meng-jixiang/vending-lane-controller/README.md

# 货道控制板 30×30 — 固件项目

> STM32F103C8T6 货道控制板固件，兼容 M109E 售货机控制卡协议

## 项目概述

30×30 货道控制板，驱动 900 通道出货机构，通过 RS-485 通讯与上位机对接。

| 项目 | 规格 |
|---|---|
| MCU | STM32F103C8T6 (72MHz, 64KB Flash, 20KB RAM) |
| 矩阵 | 30行×30列，74HC595×8片级联驱动 |
| 通讯 | RS-485, 9600bps, 兼容 M109E 协议 |
| 电流检测 | OPA2365 + 20mΩ 采样电阻, 增益21倍 |
| 输入 | 12路光耦（10路到位检测 + 2路光幕） |
| 输出 | 4路 NMOS 开关量 |
| 供电 | DC 24V → LM2596(5V) → AMS1117(3.3V) |

## 目录结构

```
├── docs/                       # 项目文档
│   ├── 固件开发项目规格书.md     # 需求规格 + 接口定义 + 验收标准
│   ├── 通讯协议规格书.md         # M109E 兼容协议详细定义
│   └── 硬件原理图分析.md         # 硬件资源分析
├── firmware/                    # 固件源码
│   ├── Core/                    # 系统初始化、启动文件
│   ├── Drivers/                 # 硬件驱动（595、ADC、UART、GPIO）
│   ├── App/                     # 应用层（电机控制、通讯协议）
│   └── Config/                  # 参数配置
├── hardware/                    # 硬件文件
│   ├── schematic/               # 原理图 PDF + 器件规格书
│   └── gerber/                  # PCB 生产文件
├── tools/                       # 上位机 / 调试工具
│   └── serial_test.py           # 串口协议测试脚本（待开发）
└── tests/                       # 测试用例
```

## 快速开始

### 硬件需求
- 货道控制板 30×30 V1.0
- ST-Link V2 或 J-Link 调试器
- DC 24V 电源
- RS-485 转 USB 适配器

### 开发环境
- Keil MDK 5.x 或 STM32CubeIDE
- ARM Compiler 6 或 GCC ARM
- STM32F1xx HAL Driver

### 编译烧录
```bash
# TODO: 补充具体编译命令
```

## 通讯协议

兼容 M109E 售货机控制卡，20 字节定长帧，CRC16-MODBUS 校验。

| 指令 | 功能 | 说明 |
|---|---|---|
| 0x01 | 获取序列号 | 返回 12 字节板卡 ID |
| 0x03 | 查询电机状态 | 运行状态/结果/电流/时间 |
| 0x05 | 启动电机 | 通道号+类型+光幕模式+超时 |
| 0x07 | 读温度 | NTC 温度值 |
| 0x08 | 开关量输出 | 4 路 NMOS 控制 |
| 0x09 | 读开关量输入 | 4 路 DI 状态 |
| 0x0B | 开停光幕 | 光幕开关 |
| 0x0C | 读光幕状态 | 遮挡检测 |
| 0x0D | 读光幕计时 | 遮挡毫秒数 |
| 0x10 | 读温湿度 | 温度 + 湿度 |
| 0x2A | 读单通道到位 | 到位开关状态 |
| 0x2B | 读一行到位 | 一行 30 通道状态 |
| 0xFF | 设置地址 | 广播设置从机地址(1-8) |

## 开发排期

| 阶段 | 周期 | 目标 |
|---|---|---|
| P0 环境搭建 | 第 1 天 | 工程模板 + 编译通过 + LED 闪烁 |
| P1 基础驱动 | 第 1 周 | 595 驱动 + UART + ADC |
| P2 通讯协议 | 第 2 周 | 帧收发 + CRC + 指令解析 |
| P3 电机控制 | 第 3-4 周 | 出货状态机 + 14 种类型 + 电流检测 |
| P4 辅助功能 | 第 5 周 | 光幕 + 继电器 + 温度 + 参数存储 |
| P5 测试验收 | 第 6 周 | 全测试用例通过 → 固件 V1.0 |

## 参考资料

- [M109E 售货机控制卡协议](docs/通讯协议规格书.md)
- [STM32F103 参考手册](https://www.st.com/resource/en/reference_manual/rm0008-stm32f101xx-stm32f102xx-stm32f103xx-stm32f105xx-and-stm32f107xx-arm-based-32-bit-mcus-stmicroelectronics.pdf)
- [74HC595 数据手册](https://www.ti.com/lit/ds/symlink/sn74hc595.pdf)

## License

Private — 仅供团队内部使用
