meng-jixiang/vending-lane-controller/docs/货道控制板30x30_固件开发项目规格书.md

# 货道控制板30×30 — 固件开发项目规格书

> **文档性质**：产品需求规格 + 技术方案 + 验收标准  
> **用途**：交付给固件开发人员，作为开发依据  
> **版本**：V1.0  
> **编制日期**：2026-06-29  

---

## 一、项目背景

### 1.1 目标
在已有30×30货道控制板硬件基础上，开发配套固件程序，实现900通道出货机构的驱动控制。

### 1.2 对标产品
- **参照产品**：M109E售货机控制卡（金华苏夏信息技术有限公司）
- **参照协议**：M109E通讯协议文档（已归档）

### 1.3 设计原则
- **协议向下兼容**：M109E上位机可直接控制本板（100通道子集）
- **裸机架构**：不使用RTOS，状态机驱动
- **资源精简**：适配STM32F103C8T6的64KB Flash / 20KB RAM

---

## 二、硬件平台确认

### 2.1 核心参数

| 项目 | 规格 | 备注 |
|---|---|---|
| MCU | STM32F103C8T6 | LQFP48, 72MHz |
| Flash | 64KB | 固件+参数存储 |
| RAM | 20KB | 状态表+缓冲区+栈 |
| 供电 | DC 24V | 经LM2596→5V→AMS1117→3.3V |
| 矩阵 | 30行×30列 | 74HC595×8片级联驱动（P端4+N端4） |
| 通道总数 | 900 | 单板全量 |

### 2.2 外设资源清单

| 外设 | 用途 | 引脚 | 备注 |
|---|---|---|---|
| USART1 | RS-485通讯 | PA9(TX)/PA10(RX) | 9600bps,主通讯口 |
| ADC1 CH0 | 电流检测通道1 | PA0 | OPA2365运放输出 |
| ADC1 CH1 | 电流检测通道2 | PA1 | 备用/电压检测 |
| GPIO | P端595控制 | PB10/PB11/PB14/PB15 | MR/STCP/SHCP/DS |
| GPIO | N端595控制 | PA4/PA5/PA6/PA7 | DS/SHCP/STCP/MR |
| GPIO | 光耦输入×12 | PB3-PB9,PB12-PB13,PA11-PA12 | 到位检测+光幕 |
| GPIO | 继电器输出×4 | PB0/PB1/PA2/PA3 | 通过光耦隔离 |
| GPIO | LED指示 | PA8 | 板载状态灯 |
| GPIO | 复位按键 | PC13 | 系统复位 |

### 2.3 光耦输入功能分配

| 输入 | GPIO | 功能 | 有效电平 | 说明 |
|---|---|---|---|---|
| INPUT_1 | PB13 | Row 0 到位检测 | 低=到位 | 30通道共享 |
| INPUT_2 | PB12 | Row 1 到位检测 | 低=到位 | 30通道共享 |
| INPUT_3 | PB9 | Row 2 到位检测 | 低=到位 | 30通道共享 |
| INPUT_4 | PB8 | Row 3 到位检测 | 低=到位 | 30通道共享 |
| INPUT_5 | PB7 | Row 4 到位检测 | 低=到位 | 30通道共享 |
| INPUT_6 | PB6 | Row 5 到位检测 | 低=到位 | 30通道共享 |
| INPUT_7 | PB5 | Row 6 到位检测 | 低=到位 | 30通道共享 |
| INPUT_8 | PB4 | Row 7 到位检测 | 低=到位 | 30通道共享 |
| INPUT_9 | PB3 | Row 8 到位检测 | 低=到位 | 30通道共享 |
| INPUT_10 | PA15 | Row 9 到位检测 | 低=到位 | 30通道共享 |
| INPUT_11 | PA12 | **光幕信号1** | 低=掉货 | NPN传感器 |
| INPUT_12 | PA11 | **光幕信号2** | 低=掉货 | 备用光幕 |

> **映射规则**：每行30个货道共享1个到位信号。启动Row N的任意货道时，检测INPUT_N判断到位。
> **Row 10-29**（600通道）无到位检测输入，仅靠超时+电流判断出货结果。

### 2.4 继电器输出分配

| 输出 | GPIO | 信号名 | 说明 |
|---|---|---|---|
| NMOS1 | PB0 | io_nmos1 | 开关量输出1 |
| NMOS2 | PB1 | io_nmos2 | 开关量输出2 |
| NMOS3 | PA2 | io_nmos3 | 开关量输出3 |
| NMOS4 | PA3 | io_nmos4 | 开关量输出4 |

### 2.5 595级联顺序

```
P端（行/正极）级联链：
  MCU → U4(Q24-Q31) → U3(Q16-Q23) → U2(Q8-Q15) → U1(Q0-Q7)
  发送顺序：先发U4数据，最后发U1数据（MSB先发）

N端（列/负极）级联链：
  MCU → U27(Q24-Q31) → U26(Q16-Q23) → U??(Q8-Q15) → U5(Q0-Q7)
  发送顺序：先发U27数据，最后发U5数据

对称结构：P端4片=32位（用30位），N端4片=32位（用30位）
```

---

## 三、功能需求

### 3.1 功能总览

| 编号 | 功能模块 | 优先级 | 说明 |
|---|---|---|---|
| F01 | 系统初始化 | P0 | 时钟/外设/看门狗初始化 |
| F02 | 74HC595矩阵驱动 | P0 | 行列选通，电机驱动基础 |
| F03 | 电机控制 | P0 | 启动/停止/状态机，兼容M109E的14种类型 |
| F04 | RS-485通讯协议 | P0 | 帧收发、CRC校验、指令解析 |
| F05 | 电流检测 | P0 | ADC采样、过流/欠流判断 |
| F06 | 到位检测 | P0 | 光耦输入读取、到位判断 |
| F07 | 光幕控制 | P1 | 光幕自检、掉货检测（IN11/IN12） |
| F08 | 开关量输出 | P1 | 4路继电器/NMOS控制 |
| F09 | 温度采集 | P1 | NTC温度读取与转换 |
| F10 | 参数存储 | P1 | 从机地址、配置参数掉电保存 |
| F11 | LED指示 | P2 | 板载LED状态指示 |
| F12 | 故障保护 | P1 | 过流/短路/超时保护 |

### 3.2 F02 — 74HC595矩阵驱动（详细）

#### 3.2.1 功能描述
通过7片74HC595级联，实现30行×30列矩阵的独立选通，控制900个通道的电机驱动。

#### 3.2.2 接口定义

```c
/**
 * @brief 初始化595控制引脚，全部输出低电平
 */
void HC595_Init(void);

/**
 * @brief 选通指定行（P端595）
 * @param row 行号 0-29，0xFF=全关
 * @note  同一时刻只能选通一行（或全关）
 *        选通=输出高电平，通过SS8050+4953驱动正极
 */
void HC595_SelectRow(uint8_t row);

/**
 * @brief 选通指定列（N端595）
 * @param col_mask 30位列的位掩码，bit0=列0...bit29=列29
 *                  1=选通（输出低，AO4812导通），0=断开
 * @note  可同时选通多列（一个电机或多电机同时驱动）
 */
void HC595_SetColumns(uint32_t col_mask);

/**
 * @brief 关闭全部输出（安全状态）
 */
void HC595_AllOff(void);
```

#### 3.2.3 时序要求
- SHCP（移位时钟）频率：1MHz ~ 4MHz（推荐2MHz）
- STCP（锁存脉冲）宽度：≥50ns
- MR（复位）脉冲宽度：≥100ns
- 移位完成后必须锁存（STCP上升沿）

#### 3.2.4 验收标准
- [ ] 能独立点亮30×30矩阵中任意一个交叉点的LED
- [ ] 能同时选通多列
- [ ] 全关操作后所有输出为低
- [ ] 移位无错位（连续切换不同行列，输出正确）

---

### 3.3 F03 — 电机控制（详细）

#### 3.3.1 电机类型定义（兼容M109E）

| 类型码 | 名称 | 驱动方式 | 到位检测 |
|---|---|---|---|
| 0x00 | 无反馈电磁铁 | P高+N低，固定时间 | 无 |
| 0x01 | 两线有反馈电磁铁 | P高+N低 | H信号 |
| 0x02 | 两线制电机 | P高+N低 | H信号（到位停） |
| 0x03 | 三线制电机 | P高+N低 | H信号（到位+运行中） |
| 0x04 | 12秒电插锁 | P高+N低，12秒超时 | 无 |
| 0x05 | 共正型两线电机 | 同0x02 | H信号 |
| 0x06 | 皮带货道 H→L→H | P高+N低 | H信号变化 |
| 0x07 | 皮带货道 L→H→L | P高+N低 | H信号变化 |
| 0x08 | 时间控制型电磁锁 | P高+N低，可配时间 | 无 |
| 0x09 | 三线有反馈电磁锁 | P高+N低 | H信号 |
| 0x0A | 反向两线（L10→L1） | 同0x02，引脚反序 | H信号 |
| 0x0B | 反向三线（L10→L1） | 同0x03，引脚反序 | H信号 |
| 0x0C | 反向无反馈电磁铁 | 同0x00，引脚反序 | 无 |
| 0x0D | 共正型无反馈电磁锁 | 同0x00 | 无 |
| 0x0E | 皮带货道 V2 | P高+N低 | H信号变化 |

> 注：类型0x0A-0x0C的"反向"在本板中不适用（595驱动无方向概念），可统一为0x02/0x03/0x00。

#### 3.3.2 出货流程状态机

```
                    ┌─────────┐
                    │  IDLE   │ ← 上位机查询结果后回到IDLE
                    └────┬────┘
                         │ 收到启动指令(0x05)
                         ▼
                    ┌─────────┐
                    │ PRECHECK│ 光幕自检（如需要）
                    └────┬────┘
                         │ 自检通过
                         ▼
                    ┌─────────┐
              ┌────→│ RUNNING │ 选通行列，启动电机
              │     └────┬────┘
              │          │ 到位/超时/光幕触发
              │          ▼
              │     ┌─────────┐
              │     │STOPPING │ 关闭驱动，记录结果
              │     └────┬────┘
              │          │
              │          ▼
              │     ┌─────────┐
              └─────┤  DONE   │ 等待上位机读取
                    └─────────┘
```

#### 3.3.3 接口定义

```c
/**
 * @brief 电机控制模块初始化
 */
void Motor_Init(void);

/**
 * @brief 启动指定通道的电机
 * @param row       行号 0-29
 * @param col       列号 0-29
 * @param type      电机类型 0x00-0x0E
 * @param laser_mode 光幕模式 0/1/2
 * @param detect_delay 微动检测延时 2-50 (×0.1s)
 * @param timeout   到位超时 1-250 (×0.1s)，0=默认7s
 * @param lock_time 时间锁动作时间 1-100 (×0.1s)
 * @return 0=已启动, 1=无效通道, 2=电机运行中, 3=上次结果未清除
 */
uint8_t Motor_Start(uint8_t row, uint8_t col, uint8_t type,
                    uint8_t laser_mode, uint8_t detect_delay,
                    uint8_t timeout, uint8_t lock_time);

/**
 * @brief 查询当前电机运行状态
 * @param status    输出：0=空闲, 1=执行中, 2=执行完毕
 * @param channel   输出：当前运行通道号 (row*30+col)
 * @param result    输出：执行结果（错误码）
 * @param peak_cur  输出：峰值电流(mA)
 * @param avg_cur   输出：平均电流(mA)
 * @param run_time  输出：运行时间(ms)
 * @param laser_cnt 输出：光幕遮挡时间(ms)
 */
void Motor_GetStatus(uint8_t *status, uint16_t *channel,
                     uint8_t *result, uint16_t *peak_cur,
                     uint16_t *avg_cur, uint16_t *run_time,
                     uint8_t *laser_cnt);

/**
 * @brief 主循环调用，驱动电机状态机
 * @note  每1ms调用一次
 */
void Motor_Process(void);
```

#### 3.3.4 执行结果码（兼容M109E）

| 代码 | 含义 | 判定条件 |
|---|---|---|
| 0x00 | 成功出货 | 到位信号有效 |
| 0x01 | 过流/负载过重/卡货 | 电流>阈值 |
| 0x02 | 欠流/断线/负载未接 | 电流<阈值 |
| 0x03 | 超时 | 超过timeout未到位 |
| 0x04 | 光幕自检失败 | 光幕模式1/2，自检时有遮挡 |
| 0x05 | 有反馈电磁铁门未开 | 类型0x01/0x09 |
| 0x0A | 微动开关未按下 | 三线制1.5s后H信号未变化 |

#### 3.3.5 验收标准
- [ ] 14种电机类型均能正确驱动
- [ ] 启动→到位→停止→返回结果 完整流程正确
- [ ] 过流/欠流/超时 故障码正确返回
- [ ] 光幕模式0/1/2 行为正确
- [ ] 连续出货100次无错位/误触发

---

### 3.4 F04 — RS-485通讯协议（详细）

#### 3.4.1 物理层
- 接口：USART1 → TP8485E-SR
- 波特率：9600bps
- 数据格式：8数据位，1停止位，无校验
- 总线模式：主从（主机=上位机，从机=货道板）
- 超时：主机等待响应超时1秒

#### 3.4.2 帧格式（兼容M109E）

```
指令帧（主机→从机），20字节：
┌──────┬──────┬──────────────────────┬──────────┐
│ 地址  │ 指令  │ Y1-Y16 数据（16字节）  │ CRC16    │
│ 1B   │ 1B   │ 16B                   │ 2B       │
└──────┴──────┴──────────────────────┴──────────┘

响应帧（从机→主机），20字节：
┌──────┬──────┬──────────────────────┬──────────┐
│ 地址  │ 指令  │ Z1-Z16 数据（16字节）  │ CRC16    │
│ 1B   │ 1B   │ 16B                   │ 2B       │
└──────┴──────┴──────────────────────┴──────────┘

CRC16-MODBUS: Poly=0x8005, Init=0xFFFF, 低字节在前
数据段不足16字节时补0
```

#### 3.4.3 通道编址方案

```
M109E兼容模式（Y1单字节）:
  Y1 = 通道号 (0-99)
  Y2 = 0

扩展模式（Y1+Y2双字节）:
  Y1 = 通道号低字节
  Y2 = 通道号高字节
  通道号 = Y1 + Y2×256 (范围 0-899)

  或者用行列方式（待定，建议与开发人员讨论选择）:
  Y1 = 行号 (0-29)
  Y2 = 列号 (0-29)
  通道号 = 行号 × 30 + 列号
```

> ⚠️ **待决策**：通道编址用"线性编号"还是"行列编号"？建议线性编号，与M109E更兼容。

#### 3.4.4 指令详细定义

##### 0x01 — 获取序列号

```
请求: [addr][01][00×16][CRC]
响应: [00][01][Z1-Z12=序列号][00×4][CRC]
```

##### 0x03 — 查询电机运行状态

```
请求: [addr][03][00×16][CRC]
响应: [00][03][Z1][Z2-Z3][Z4][Z5-Z6][Z7-Z8][Z9-Z10][Z11][00×5][CRC]

Z1:     运行状态 (0=空闲, 1=执行中, 2=完成)
Z2-Z3:  通道号 (16bit, 高字节在前)
Z4:     执行结果 (错误码)
Z5-Z6:  峰值电流 mA
Z7-Z8:  平均电流 mA
Z9-Z10: 运行时间 ms
Z11:    光幕遮挡时间 ms
```

##### 0x05 — 启动电机

```
请求: [addr][05][Y1][Y2][Y3][Y4][Y5][Y6][Y7][00×9][CRC]

Y1:     通道号低字节 (0-255)
Y2:     通道号高字节 (0=通道0-255, 1=256-511, 2=512-767, 3=768-899)
Y3:     电机类型 (0x00-0x0E)
Y4:     光幕模式 (0=不参考, 1=自检+到位停, 2=自检+掉货停)
Y5:     微动检测延时 2-50 (×0.1s)，默认15(1.5s)
Y6:     保留
Y7:     到位超时 1-250 (×0.1s)，0=默认70(7s)
Y8:     时间锁动作时间 1-100 (×0.1s)

响应: [00][05][Z1][00×15][CRC]
Z1: 启动结果 (0=已启动, 1=无效通道, 2=其他电机运行中, 3=上次结果未清除)
```

##### 0x07 — 读温度

```
请求: [addr][07][00×16][CRC]
响应: [00][07][Z1-Z2][00×14][CRC]

Z1-Z2: 温度值 (有符号16bit, ×0.1℃)
       例: 0x01F4 = 500 = 50.0℃
           0xFE0C = -500 = -50.0℃
       未接传感器返回 -50.0℃ (0xFE0C)
```

##### 0x08 — 开关量输出

```
请求: [addr][08][Y1][Y2][00×14][CRC]
Y1: DO索引 (0-3)
Y2: 操作 (1=ON, 0=OFF)

响应: [00][08][Z1][Z2][00×14][CRC]
Z1: DO索引
Z2: 操作结果 (Y2+0xF0)
```

##### 0x09 — 读开关量输入

```
请求: [addr][09][00×16][CRC]
响应: [00][09][Z1-Z4][00×12][CRC]

Z1-Z4: DI1-DI4状态 (1=外部连接, 0=断开)
```

##### 0x0B — 开停光幕

```
请求: [addr][0B][Y1][00×15][CRC]
Y1: 1=开, 0=关

响应: [00][0B][Z1][00×15][CRC]
Z1: 操作结果
```

##### 0x0C — 读光幕状态

```
请求: [addr][0C][00×16][CRC]
响应: [00][0C][Z1][Z2][00×14][CRC]

Z1: 光幕1状态 (1=有遮挡, 0=无遮挡) — INPUT_11
Z2: 光幕2状态 (1=有遮挡, 0=无遮挡) — INPUT_12
```

##### 0x0D — 读光幕遮挡计时

```
请求: [addr][0D][00×16][CRC]
响应: [00][0D][Z1][Z2][00×14][CRC]

Z1: 光幕1遮挡毫秒数
Z2: 光幕2遮挡毫秒数
注: 光幕开停时计数归零
```

##### 0x10 — 读温湿度

```
请求: [addr][10][00×16][CRC]
响应: [00][10][Z1][Z2][Z3][00×13][CRC]

Z1: 湿度 (本板无DHT11，固定返回0)
Z2: 温度 (同0x07指令)
Z3: 读取失败指示 (固定返回1，表示非最新采样)
```

##### 0x2A — 读单通道到位开关

```
请求: [addr][2A][Y1][Y2][00×14][CRC]
Y1: 通道号低字节
Y2: 通道号高字节

响应: [00][2A][Z1][00×15][CRC]
Z1: 0=未到位, 1=到位
```

##### 0x2B — 读一行到位开关

```
请求: [addr][2B][Y1][00×15][CRC]
Y1: 行号 (0-29)

响应: [00][2B][Z1-Z10][00×6][CRC]
Z1-Z10: 每列的到位状态 (bit0-bit7对应8个通道)
        共30列需要4字节，但M109E用10字节(100通道)
        本板需扩展或只返回前80通道
```

> ⚠️ **待讨论**：0x2B指令在30列时如何编码？建议用Z1-Z4(32bit)表示30列。

##### 0xFF — 设置从机地址

```
请求: [FF][01][00×16][CRC]  ← 设置为地址1
请求: [FF][02][00×16][CRC]  ← 设置为地址2
...
请求: [FF][08][00×16][CRC]  ← 设置为地址8

响应: 无（广播地址）
注意: 设置后指示灯闪烁次数=新地址
```

#### 3.4.5 通讯时序

```
主机发送指令
    ↓
等待 50ms
    ↓
从机响应（超时 1000ms）
    ↓
主机处理响应
    ↓
可发起下一条指令
```

#### 3.4.6 验收标准
- [ ] 所有指令均能正确收发
- [ ] CRC16校验正确（用M109E的示例数据验证）
- [ ] 20字节定长帧解析无误
- [ ] 地址匹配（只响应本机地址和广播地址255）
- [ ] 超时处理正确
- [ ] 连续收发1000帧无错误

---

### 3.5 F05 — 电流检测（详细）

#### 3.5.1 硬件参数
- 采样电阻：R85 = 20mΩ（GND与DGND之间）
- 运放：OPA2365AIDR（U23.1），同相放大器
- 输入电阻：R99 = 1kΩ
- 反馈电阻：R100 = 20kΩ
- **增益 = 1 + 20k/1k = 21倍**
- ADC串联保护：R108 = 10Ω
- 钳位二极管：D1 = 1N5819HW
- ADC：12bit，3.3V参考，通道ADCX_IN0 (PA0)

#### 3.5.2 换算公式

```
V_shunt = I_load × 0.020Ω
V_out   = V_shunt × 21 = I_load × 0.42 V/A
ADC值   = V_out / 3.3 × 4096

I_load(mA) = ADC值 × 1.91

参考值：
  1A  → ADC ≈ 524
  2A  → ADC ≈ 1048
  3A  → ADC ≈ 1572
  5A  → ADC ≈ 2620
```

#### 3.5.3 接口定义

```c
/**
 * @brief 电流检测模块初始化
 */
void ADC_Sense_Init(void);

/**
 * @brief 启动一次ADC采样（电机运行期间周期调用）
 * @note  建议每10ms采样一次
 */
void ADC_Sense_Start(void);

/**
 * @brief 获取当前电流值
 * @return 电流值(mA)
 */
uint16_t ADC_Sense_GetCurrent(void);

/**
 * @brief 获取本次运行的峰值电流
 * @return 峰值电流(mA)
 */
uint16_t ADC_Sense_GetPeak(void);
```

#### 3.5.4 电流判定阈值

| 场景 | 阈值 | ADC阈值 | 说明 |
|---|---|---|---|
| 过流 | >3250mA | ADC > 1701 | AO4812降额上限(70°C×50%) |
| 过流保护 | >4000mA | ADC > 2094 | 硬件极限保护 |
| 欠流 | <50mA | ADC < 26 | 返回错误码0x02 |
| 正常 | 50-3250mA | ADC 26-1701 | 正常范围 |

> **AO4812降额依据**：额定8.5A(25°C)/6.5A(70°C)，按50%降额 → 工作上限3.25A。
> 阈值需要实际电机测试后微调，以上为初始计算值。

#### 3.5.4 验收标准
- [ ] 静态电流读数稳定（无电机运行时接近0mA）
- [ ] 电机运行时电流读数与万用表偏差<10%
- [ ] 过流/欠流判定正确

---

### 3.6 F07 — 光幕控制（详细）

#### 3.6.1 硬件连接
- 光幕1：INPUT_11 (PA12) — NPN型光幕传感器
- 光幕2：INPUT_12 (PA11) — 备用光幕
- 光幕供电：需外部供电（本板不控制光幕电源）

#### 3.6.2 信号逻辑
- **常态（无掉货）**：NPN截止 → 4.7kΩ上拉至+24V → 光耦截止 → MCU读到**高电平**
- **掉货检测**：NPN导通 → 拉低 → 光耦导通 → MCU读到**低电平**
- **有效电平**：**低电平 = 检测到掉货**

```
无掉货:  PA12/PA11 = HIGH (1)
有掉货:  PA12/PA11 = LOW  (0)
```

#### 3.6.3 工作模式（兼容M109E）

| 模式 | 说明 |
|---|---|
| 0 | 电机运转不参考光幕 |
| 1 | 启动前光幕自检→自检通过才启动→到位后停止 |
| 2 | 启动前光幕自检→自检通过才启动→掉货检测到立即停止→未检测到则超时停止 |

#### 3.6.4 光幕自检逻辑

```
自检流程:
1. 读取INPUT_11/INPUT_12状态
2. 如果为低电平（有遮挡/有掉货）→ 自检失败 → 返回错误码0x04
3. 如果为高电平（无遮挡）→ 自检通过 → 启动电机

掉货检测（模式2）:
1. 电机运行中持续监测INPUT_11/INPUT_12
2. 检测到低电平（NPN导通=掉货）→ 记录遮挡时间 → 立即停止电机
3. 遮挡时间 > 0 表示有掉货
```

#### 3.6.5 验收标准
- [ ] 模式0：光幕状态不影响电机运行
- [ ] 模式1：光幕为低电平（掉货）时自检失败，返回0x04
- [ ] 模式2：电机运行中检测到低电平后立即停止
- [ ] 遮挡计时准确
- [ ] 常态（高电平）时不会误触发

---

### 3.7 F10 — 参数存储（详细）

#### 3.7.1 需存储的参数

| 参数 | 大小 | 说明 |
|---|---|---|
| 从机地址 | 1字节 | 1-8 |
| 电机类型配置表 | 300字节 | 每通道1字节（可选，或由上位机管理） |
| 电流校准值 | 4字节 | 零点偏移+增益系数 |
| 序列号 | 12字节 | 板卡唯一标识 |

#### 3.7.2 存储方案
使用STM32 Flash模拟EEPROM（页擦除方式）：
- 使用Flash最后1-2页（每页1KB）
- 需要均衡磨损算法

#### 3.7.3 验收标准
- [ ] 掉电后参数不丢失
- [ ] 修改参数后重新上电读取正确
- [ ] Flash写入次数>10000次无损坏

---

## 四、RAM分配方案

```
STM32F103C8T6 RAM = 20480 字节

分配：
  栈 (Stack)              : 2048 字节
  堆 (Heap)               : 512 字节
  .bss + .data (全局变量)  : ~1500 字节
  通讯收发缓冲            : 40+40 = 80 字节
  ADC采样缓冲             : 64 字节
                         ──────────────
  固定开销                : ~4200 字节

  货道状态表 (300通道)     : 1500 字节 (5字节/通道)
  电机运行上下文           : 32 字节
  故障日志 (最近10条)      : 100 字节
                         ──────────────
  业务数据                : ~1632 字节

  总计                    : ~5832 字节
  剩余                    : ~14648 字节 ✅ 充裕
```

---

## 五、Flash分配方案

```
STM32F103C8T6 Flash = 65536 字节

分配：
  Bootloader (可选)       : 4096 字节 (0x0000-0x0FFF)
  固件代码                : ~40000 字节 (预估)
  参数存储区              : 2048 字节 (最后2页)
  向量表 + 中断           : ~512 字节
                         ──────────────
  总计                    : ~46656 字节
  剩余                    : ~18880 字节 ✅ 可行
```

---

## 六、开发交付物清单

| 编号 | 交付物 | 格式 | 说明 |
|---|---|---|---|
| D01 | 源代码工程 | Keil MDK / STM32CubeIDE | 含Makefile/工程文件 |
| D02 | 协议文档 | .md 或 .pdf | 所有指令的详细定义 |
| D03 | 接口文档 | .md 或 .pdf | 所有模块的API说明 |
| D04 | 测试报告 | .md 或 .pdf | 各模块测试结果 |
| D05 | 已烧录固件 | .hex / .bin | 可直接烧录的固件文件 |
| D06 | 串口调试工具 | .exe / .py | 可选，用于测试指令收发 |

---

## 七、验收测试用例

### 7.1 基础功能测试

| 编号 | 测试项 | 操作 | 预期结果 |
|---|---|---|---|
| T01 | 上电初始化 | 上电 | LED闪烁N次(N=从机地址)，串口无异常输出 |
| T02 | 获取ID | 发送0x01指令 | 返回12字节序列号 |
| T03 | 设置地址 | 发送0xFF指令 | 指示灯闪烁次数变化，新地址生效 |
| T04 | 读温度 | 发送0x07指令 | 返回NTC温度值，未接时返回-50.0℃ |
| T05 | 开关量输出 | 发送0x08指令 | 对应NMOS导通/关断 |
| T06 | 读开关量 | 发送0x09指令 | 返回DI1-DI4状态 |

### 7.2 电机驱动测试

| 编号 | 测试项 | 操作 | 预期结果 |
|---|---|---|---|
| T10 | 无反馈电磁铁 | 类型0x00，启动通道(0,0) | 运行timeout后返回0x00(成功) |
| T11 | 两线制电机 | 类型0x02，启动通道(0,0) | 到位后返回0x00 |
| T12 | 三线制电机 | 类型0x03，启动通道(0,0) | 到位后返回0x00 |
| T13 | 过流故障 | 启动短路通道 | 返回0x01 |
| T14 | 超时故障 | 启动无负载通道 | 返回0x03 |
| T15 | 通道冲突 | 运行中再发启动 | 返回0x02(电机运行中) |
| T16 | 全通道遍历 | 依次启动(0,0)到(29,29) | 每个通道均能正确启动 |

### 7.3 光幕测试

| 编号 | 测试项 | 操作 | 预期结果 |
|---|---|---|---|
| T20 | 光幕自检通过 | 模式1，光幕无遮挡 | 正常启动电机 |
| T21 | 光幕自检失败 | 模式1，遮挡光幕 | 返回0x04 |
| T22 | 掉货检测 | 模式2，运行中遮挡光幕 | 电机立即停止 |
| T23 | 读光幕状态 | 发送0x0C | 返回双光幕状态 |

### 7.4 稳定性测试

| 编号 | 测试项 | 操作 | 预期结果 |
|---|---|---|---|
| T30 | 连续出货 | 循环出货1000次 | 无死机/错位/误触发 |
| T31 | 通讯压力 | 1秒发10条指令 | 全部正确响应，无丢帧 |
| T32 | 掉电恢复 | 运行中突然断电 | 重启后正常工作 |
| T33 | 长时间运行 | 连续运行72小时 | 无异常 |

---

## 八、风险与待确认事项

### 8.1 待确认（需与硬件确认）

| 编号 | 问题 | 影响 | 建议 |
|---|---|---|---|
| Q01 | ~~N端595只有3片=24位~~ | ~~矩阵驱动方案~~ | ✅ 已确认：N端4片=32位，足够30路 |
| Q02 | ~~电流检测运放增益是多少？~~ | ~~电流检测精度~~ | ✅ 已确认：增益21倍，I(mA)=ADC×1.91 |
| Q03 | ~~光幕信号的有效电平？~~ | ~~光幕逻辑~~ | ✅ 已确认：NPN传感器，低电平=掉货，常态高电平 |
| Q04 | ~~到位检测(INPUT_1~10)的映射关系？~~ | ~~到位检测方案~~ | ✅ 已确认：Row0→IN1, Row1→IN2, ...Row9→IN10，每行30通道共享 |
| Q05 | ~~电机驱动电流最大多少？AO4812额定电流是否够用？~~ | ~~可靠性~~ | ✅ 已确认：AO4812额定8.5A/6.5A(70°C)，50%降额→上限3.25A |

### 8.2 已知风险

| 风险 | 概率 | 影响 | 应对 |
|---|---|---|---|
| RAM不足 | 低 | 功能受限 | 已精简到5字节/通道，预留充裕 |
| Flash不足 | 低 | 无法存储全部功能 | 64KB够用，控制代码量 |
| 电流检测精度不足 | 中 | 误判故障 | 需实测校准，软件滤波 |
| 595移位错位 | 中 | 误触发货 | 每次操作前复位595 |
| 通讯抗干扰差 | 中 | 丢帧 | 重试机制+超时处理 |

---

## 九、开发环境要求

| 项目 | 要求 |
|---|---|
| IDE | Keil MDK 5.x 或 STM32CubeIDE |
| 编译器 | ARM Compiler 6 或 GCC ARM |
| HAL库 | STM32F1xx HAL Driver |
| 调试器 | ST-Link V2 或 J-Link |
| 测试工具 | 串口调试助手（SSCOM/友善串口） |
| 参考文档 | M109E协议文档、STM32F103参考手册 |

---

## 十、项目排期建议

| 阶段 | 周期 | 内容 | 交付物 |
|---|---|---|---|
| **阶段一：基础驱动** | 第1-2周 | 595驱动、GPIO、UART、ADC | LED扫描+串口收发 |
| **阶段二：核心功能** | 第3-4周 | 电机控制、通讯协议、电流检测 | 完整出货流程 |
| **阶段三：辅助功能** | 第5周 | 光幕、继电器、温度、参数存储 | 全功能可用 |
| **阶段四：测试验收** | 第6周 | 全部测试用例执行、Bug修复 | 固件V1.0 |

---

> **文档版本**：V1.0  
> **编制**：产品经理  
> **日期**：2026-06-29  
> **状态**：待团队评审
