meng-jixiang/vending-lane-controller/CHANGELOG.md

# Changelog

## [Unreleased] - 2026-07-02

### Added
- 项目初始化
- 固件开发项目规格书 V1.0
- 通讯协议规格书 V1.0（M109E 兼容）
- 硬件原理图分析文档
- PCB Gerber 文件（2026-06-29 版本）
- MOSFET 4953 规格书
