meng-jixiang/vending-lane-controller/hardware/schematic/SCH_Schematic1_2026-06-29.pdf

# MR# 10 SHCP 11 STCP 12 OE# 13 DS 14 Q0 15 VCC 16

# MR# 10 SHCP 11 STCP 12 OE# 13 DS 14 Q0 15 VCC 16

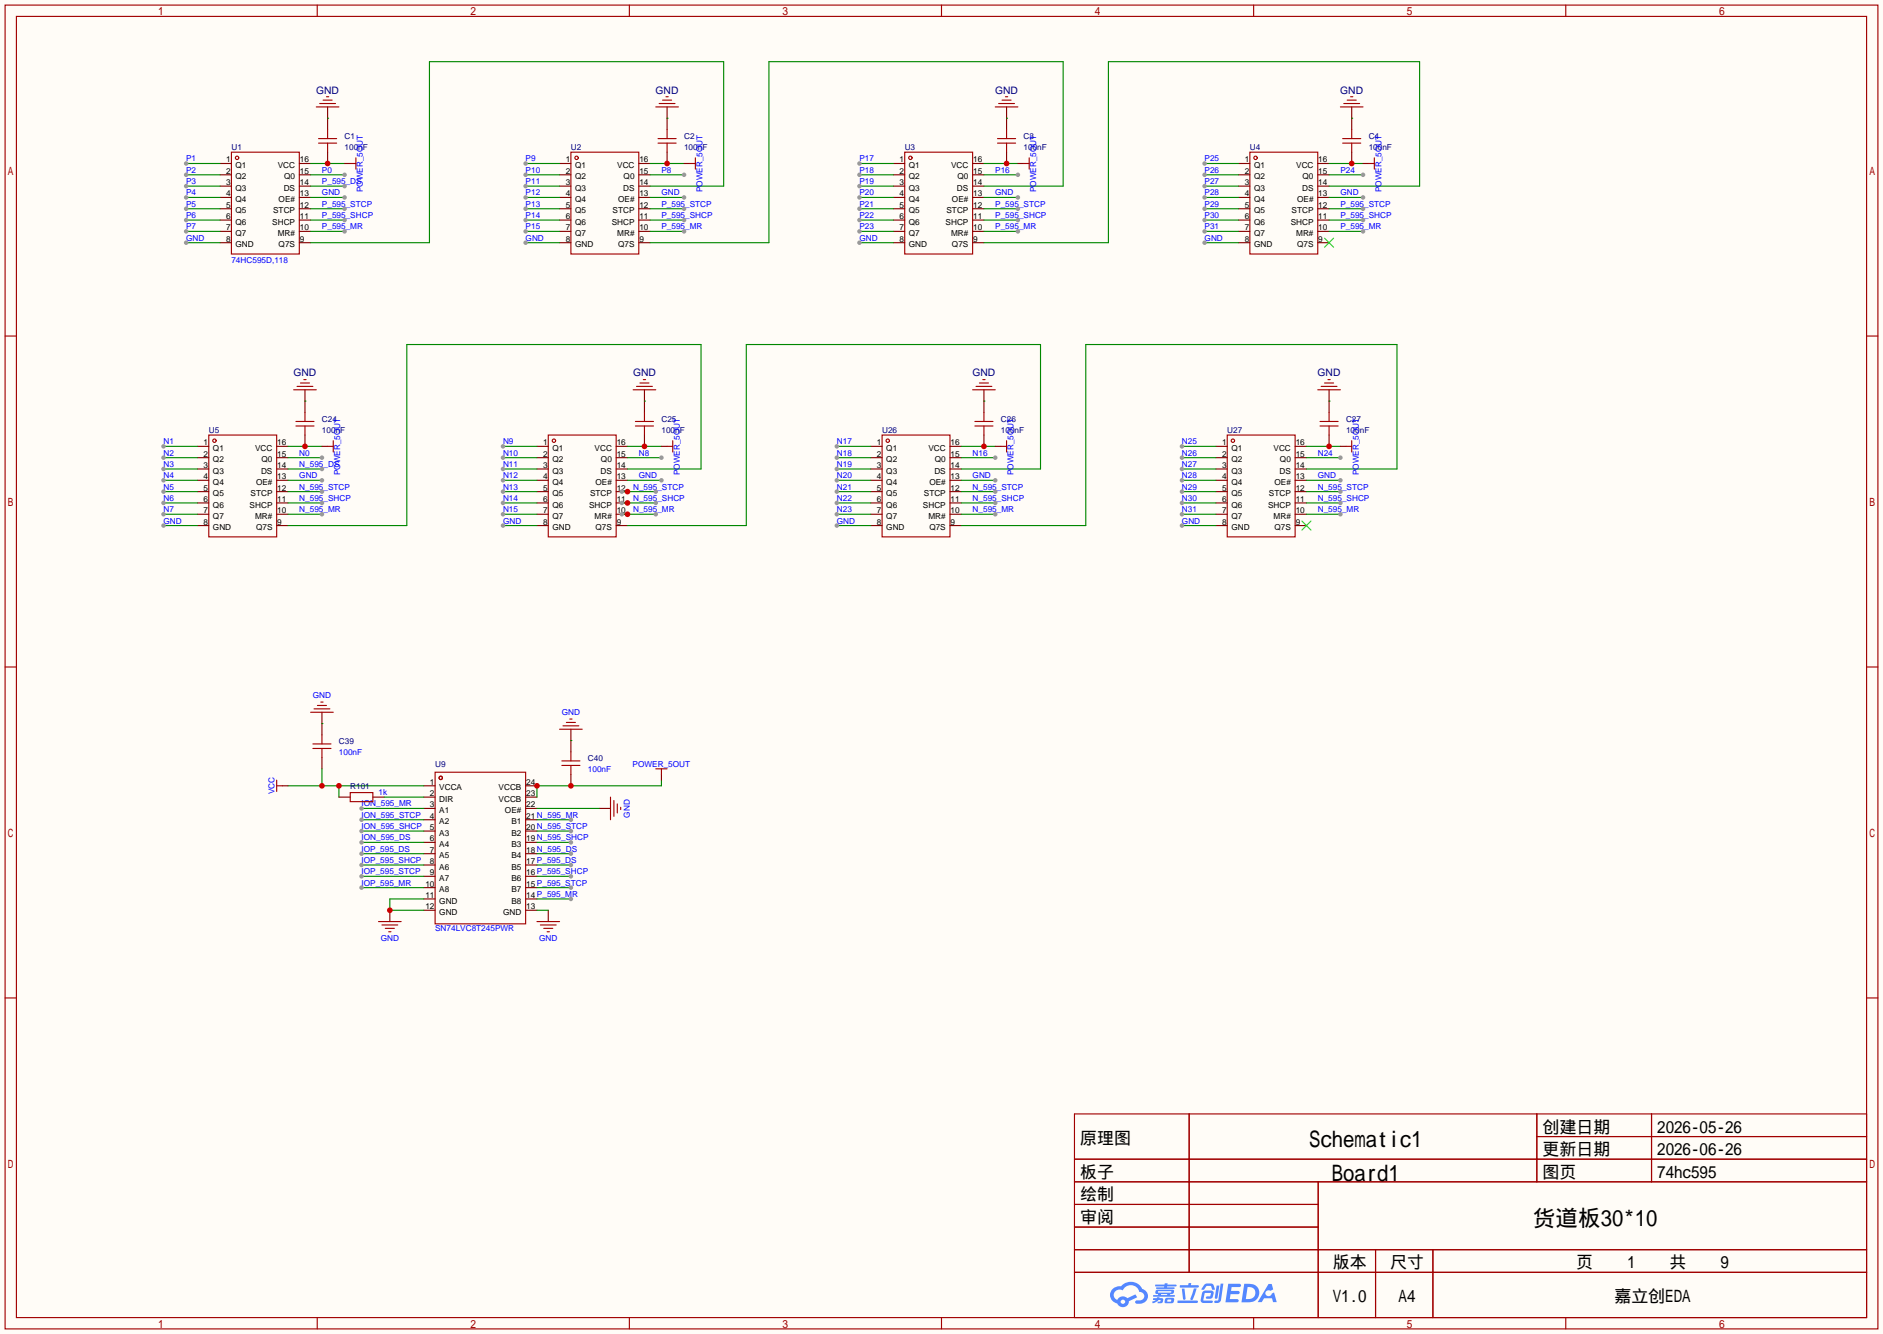
[picture p1: page 1]

MR# 10 SHCP 11 STCP 12 OE# 13 DS 14 Q0 15 VCC 16

原理图 | Schematic1 | 创建日期 | 2026-05-26

更新日期 | 2026-06-26

板子 | Board1 | 图页 | 74hc595
绘制 | | 货道板30*10
审阅

V1.0 | A4 | 嘉立创EDA

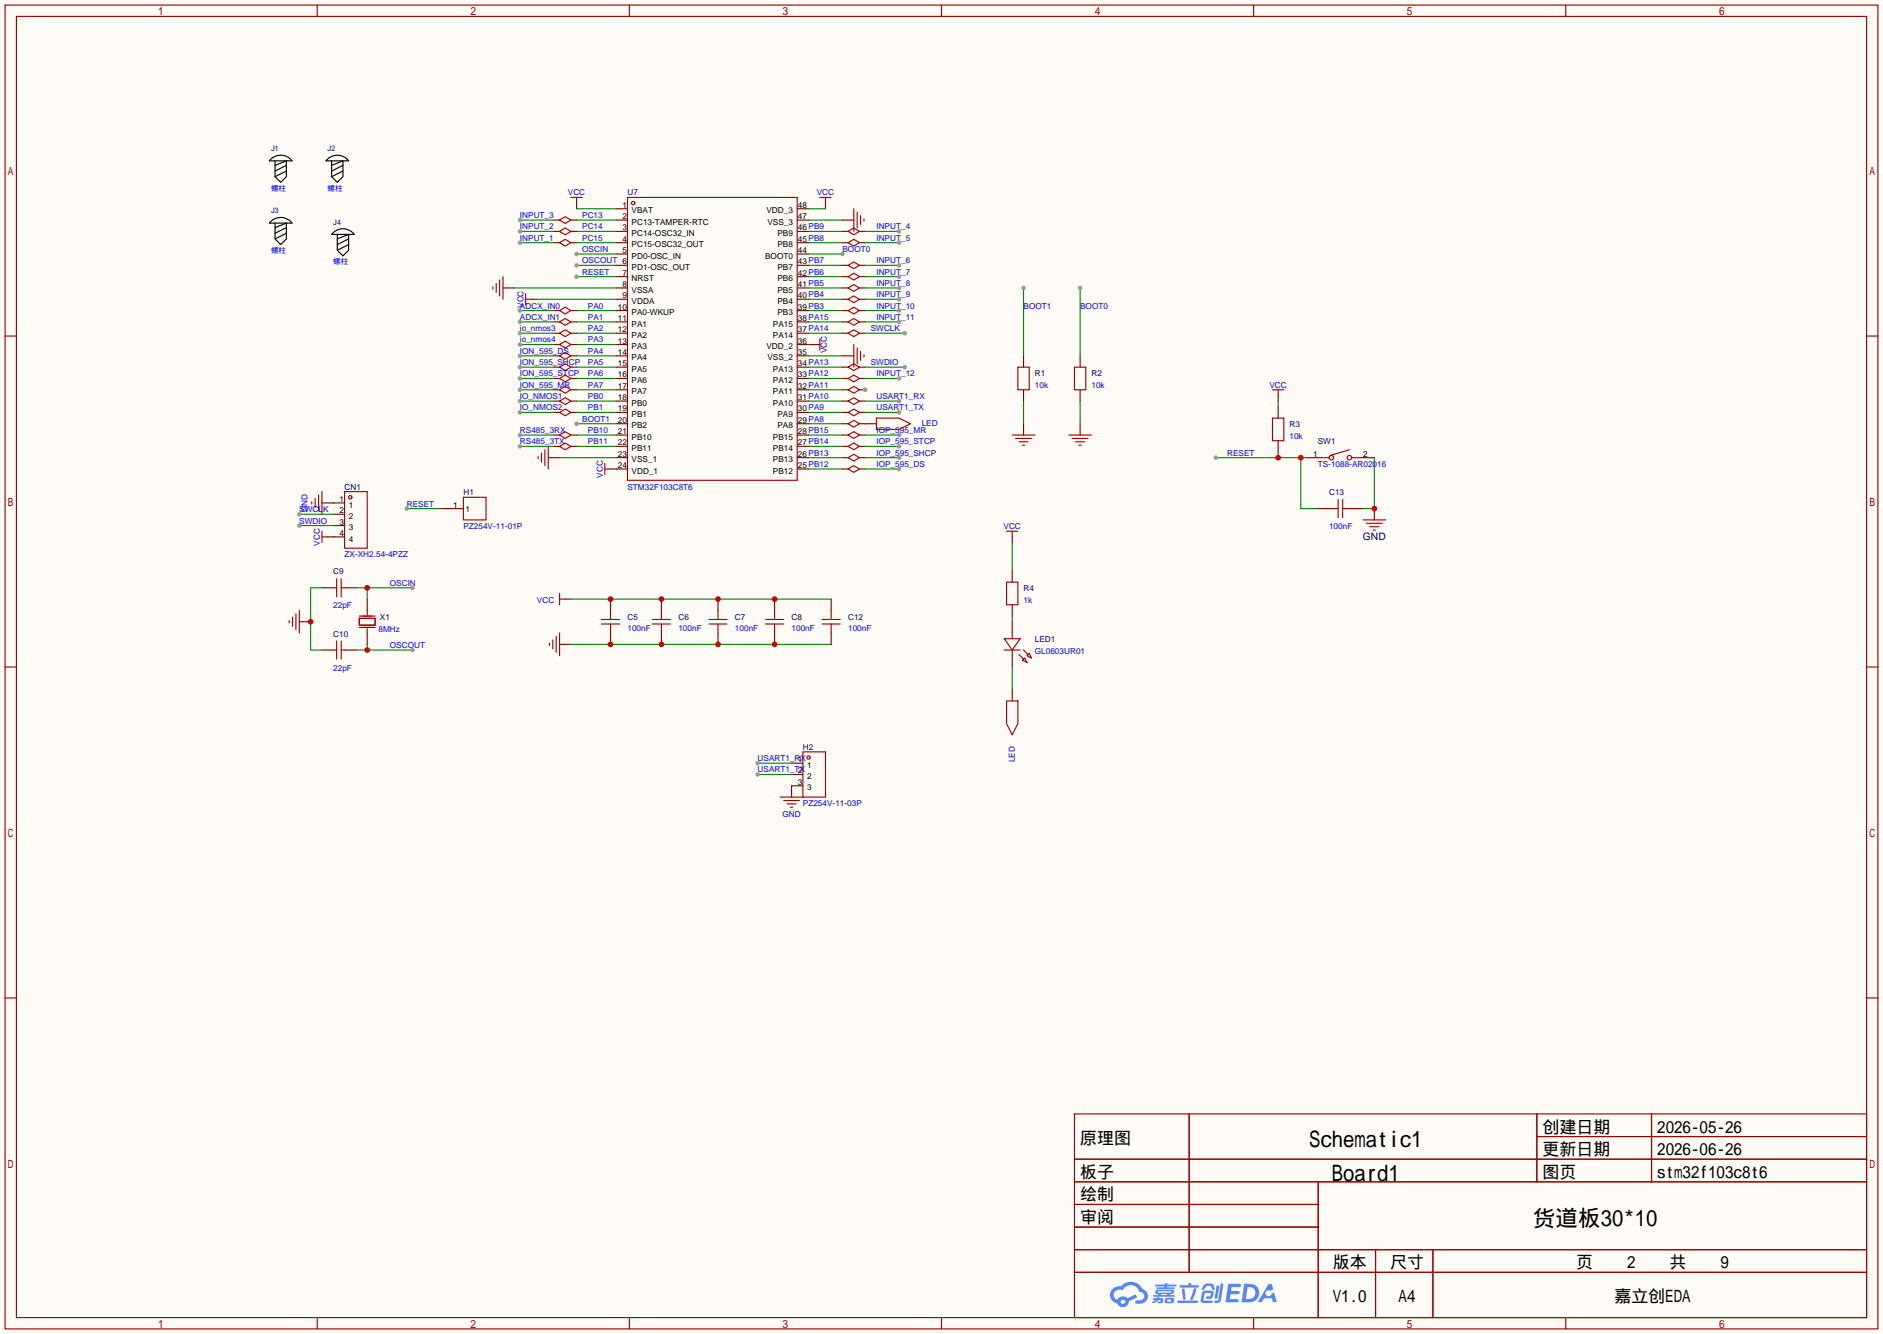
[picture p2: page 2]

原理图 | Schematic1 | 创建日期 | 2026-05-26

更新日期 | 2026-06-26

板子 | Board1 | 图页 | stm32f103c8t6
绘制 | | 货道板30*10
审阅

GND | GND | GND | GND | GND P⁰ | P¹ | P² | P³ | P⁴ P⁵ | P⁶ | P⁷ | P⁸ | P⁹ P¹⁰ | P¹¹ | P¹² | P¹³ | P¹⁴ P¹⁵ | P¹⁶ | P¹⁷ | P¹⁸ | P¹⁹ P²⁰ | P²¹ | P²² | P²³ | P²⁴ P²⁵ | P²⁶ | P²⁷ | P²⁸ | P²⁹

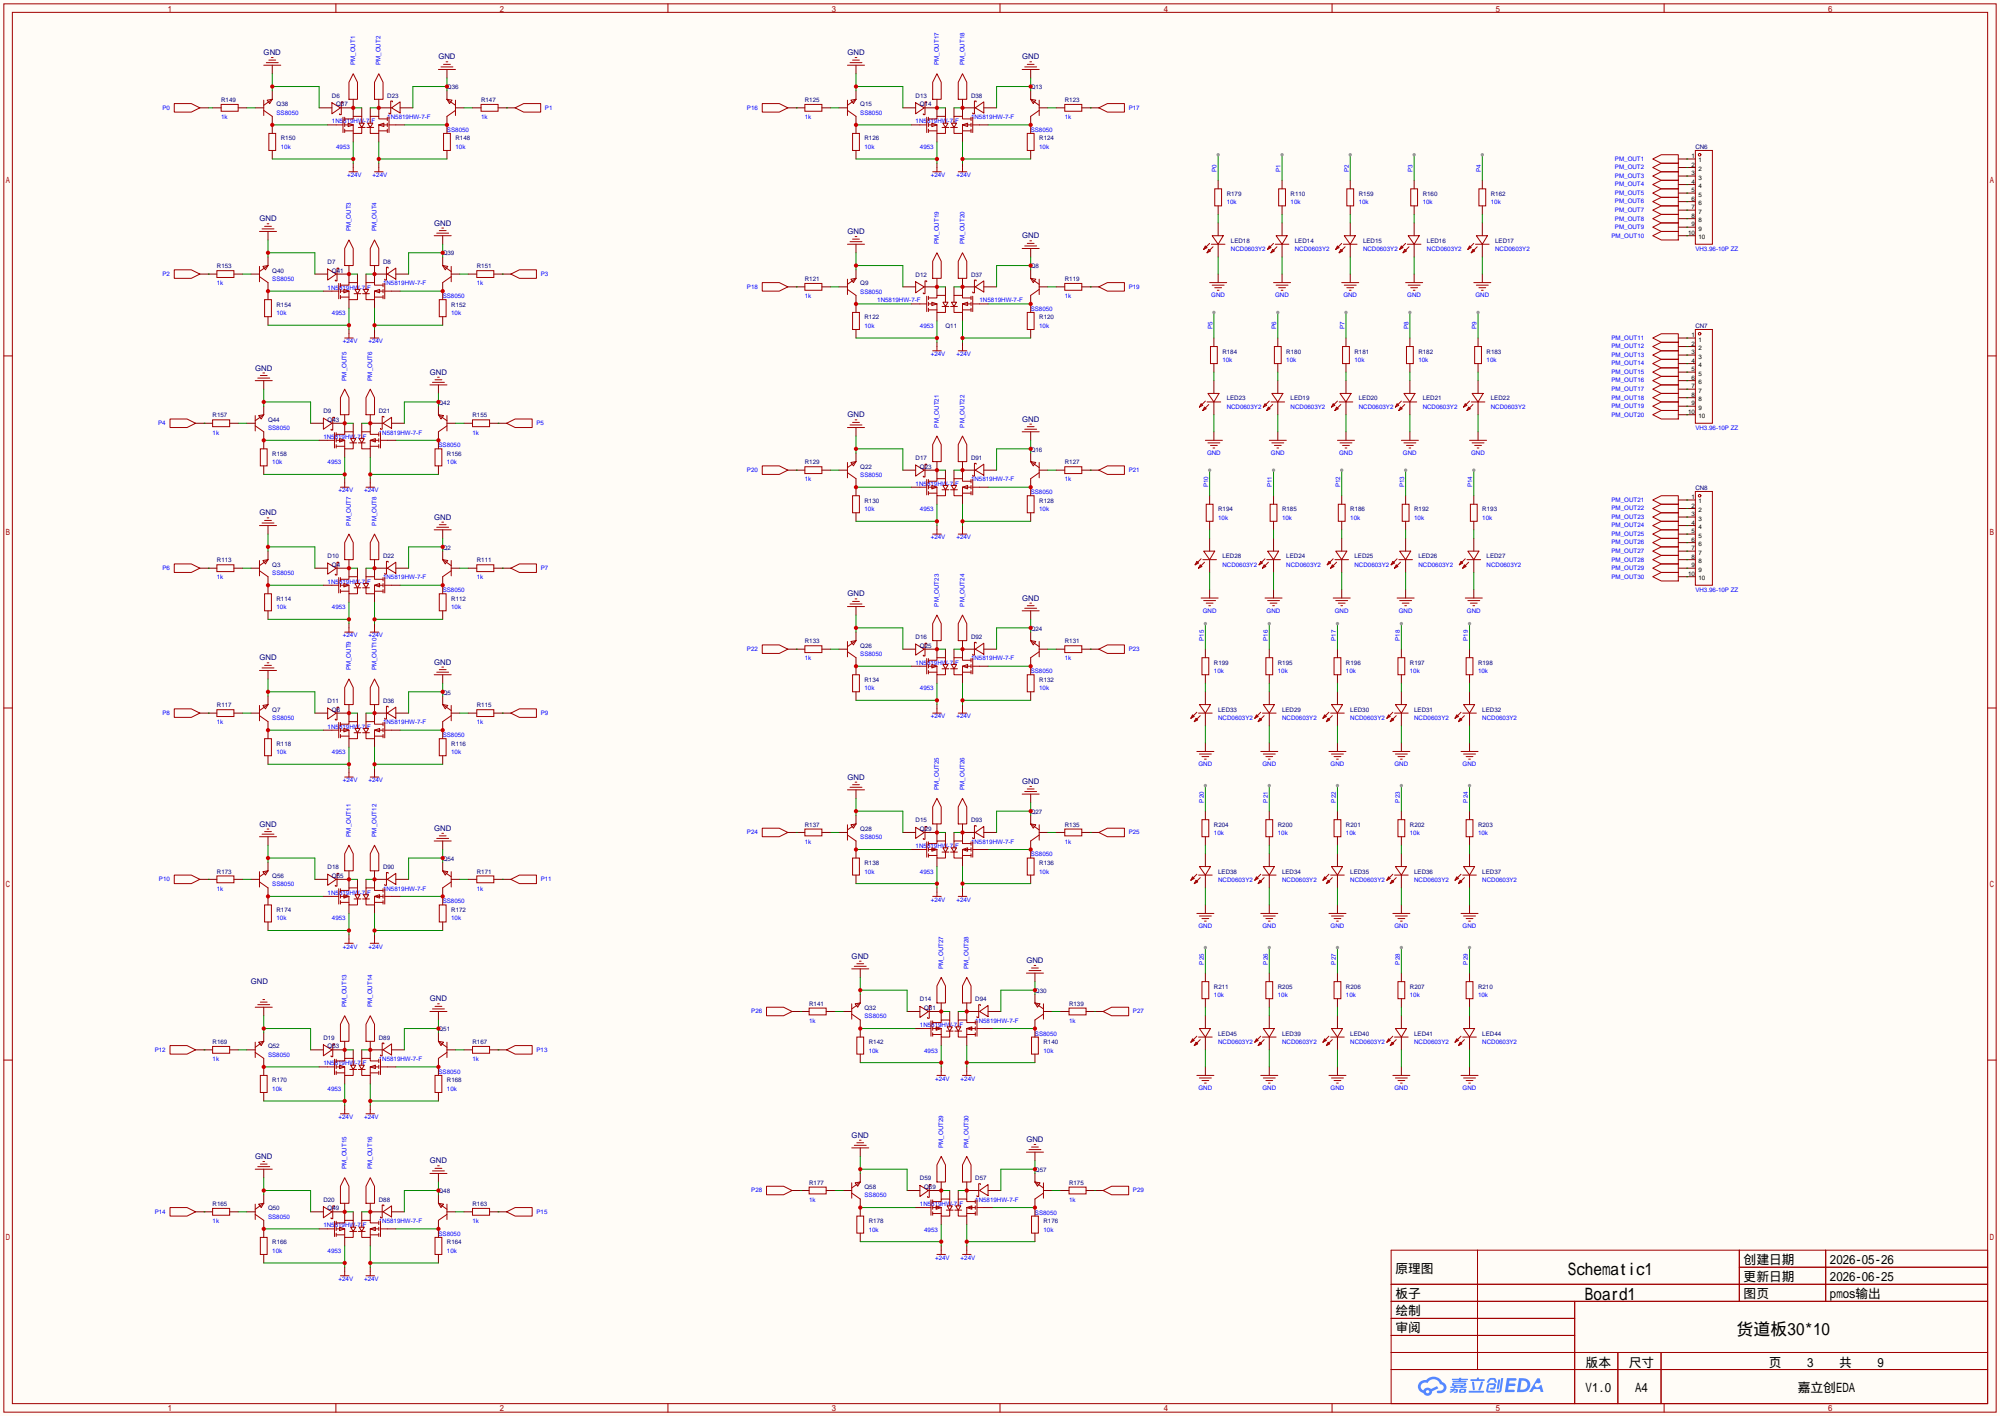
[picture p3: page 3]

原理图 | Schematic1 | 创建日期 | 2026-05-26

更新日期 | 2026-06-25

板子 | Board1 | 图页 | pmos输出
绘制 | | 货道板30*10
审阅

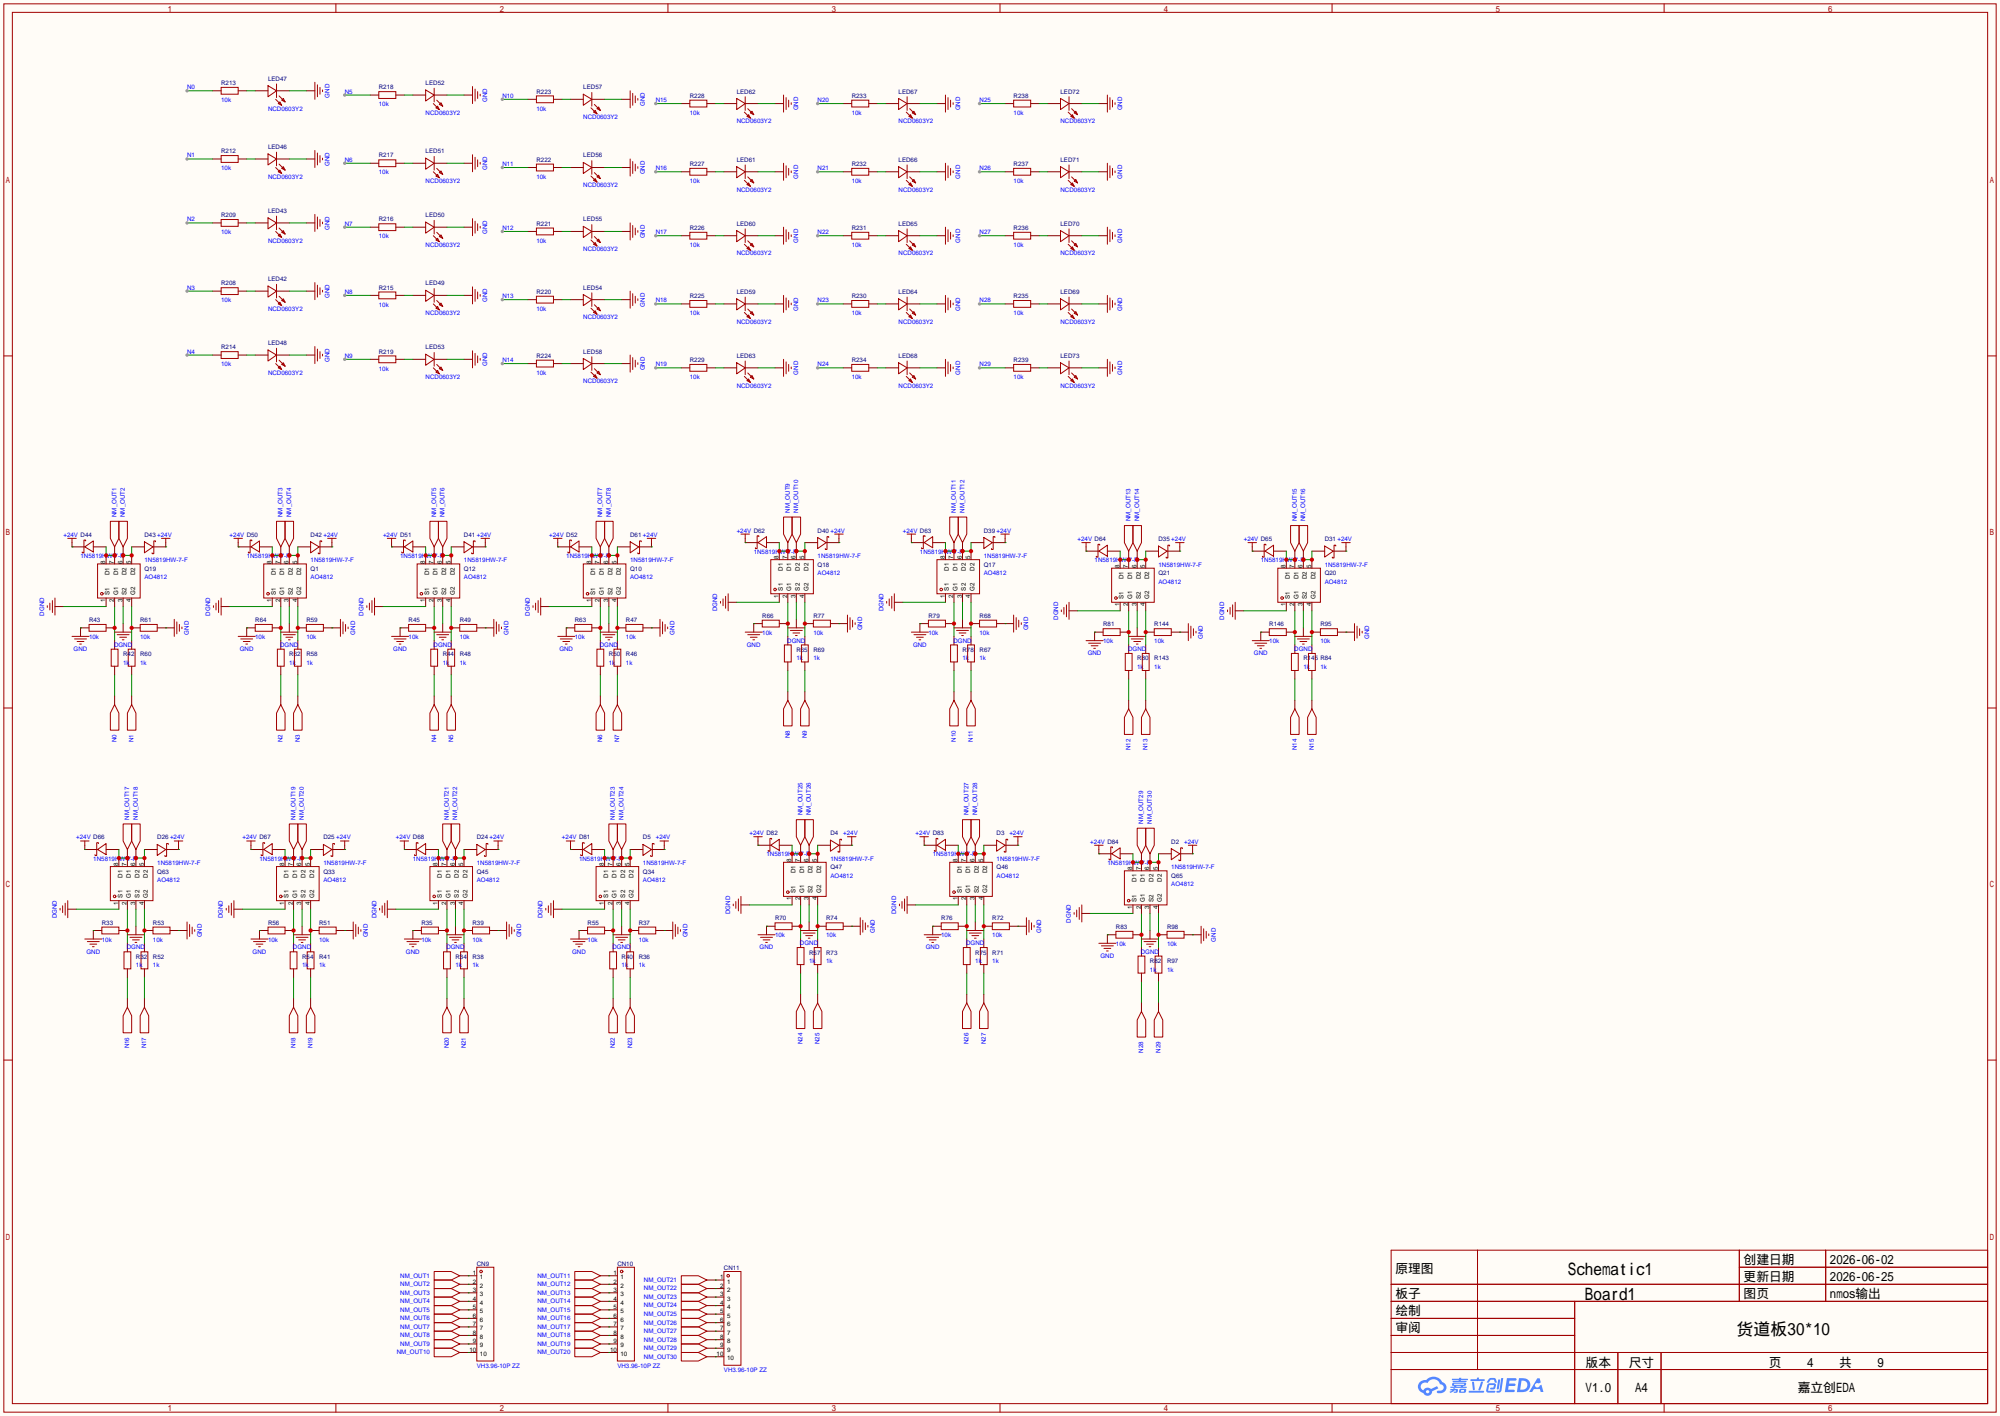
[picture p4: page 4]

GND GND GND GND GND

原理图 | Schematic1 | 创建日期 | 2026-06-02

更新日期 | 2026-06-25

板子 | Board1 | 图页 | nmos输出
绘制 | | 货道板30*10
审阅

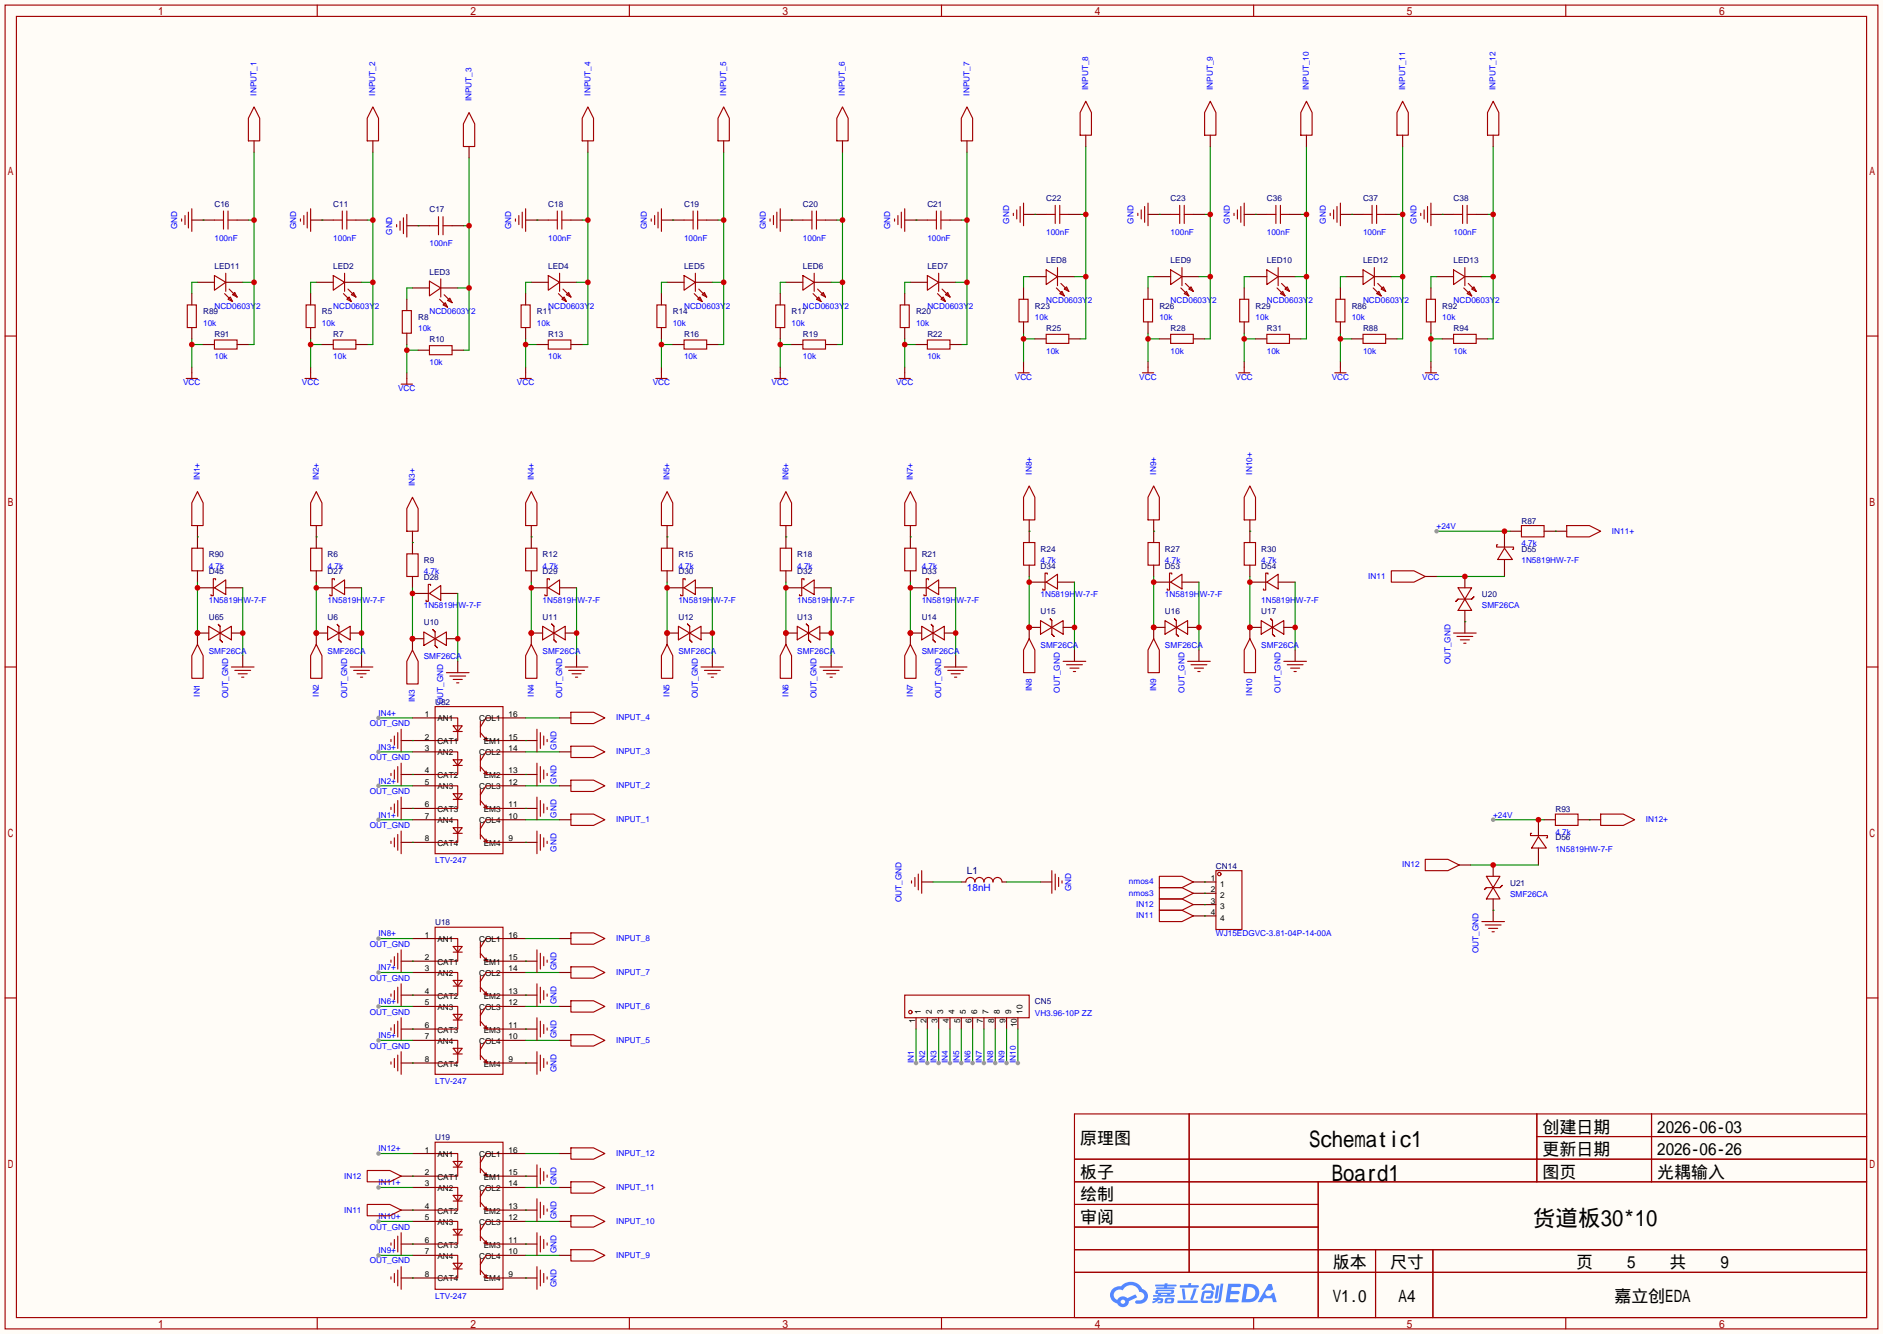
[picture p5: page 5]

GND GND GND GND GND GND

原理图 | Schematic1 | 创建日期 | 2026-06-03

更新日期 | 2026-06-26

板子 | Board1 | 图页 | 光耦输入
绘制 | | 货道板30*10
审阅

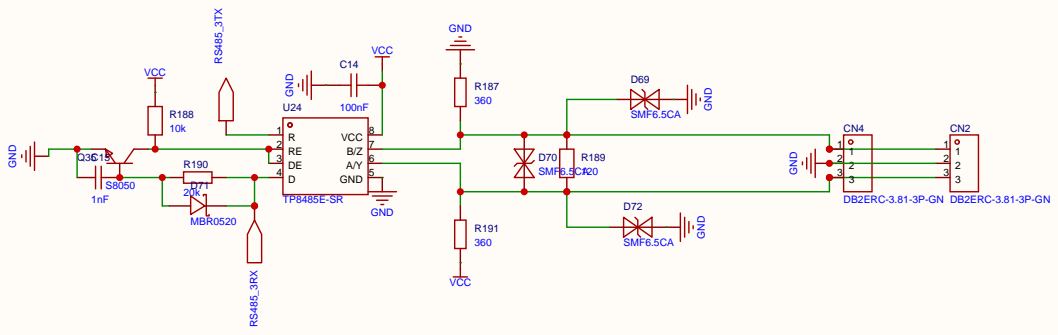
[picture p6: page 6]

原理图 | Schematic1 | 创建日期 | 2026-06-04

更新日期 | 2026-06-12

板子 | Board1 | 图页 | 485通讯
绘制 | | 货道板30*10
审阅

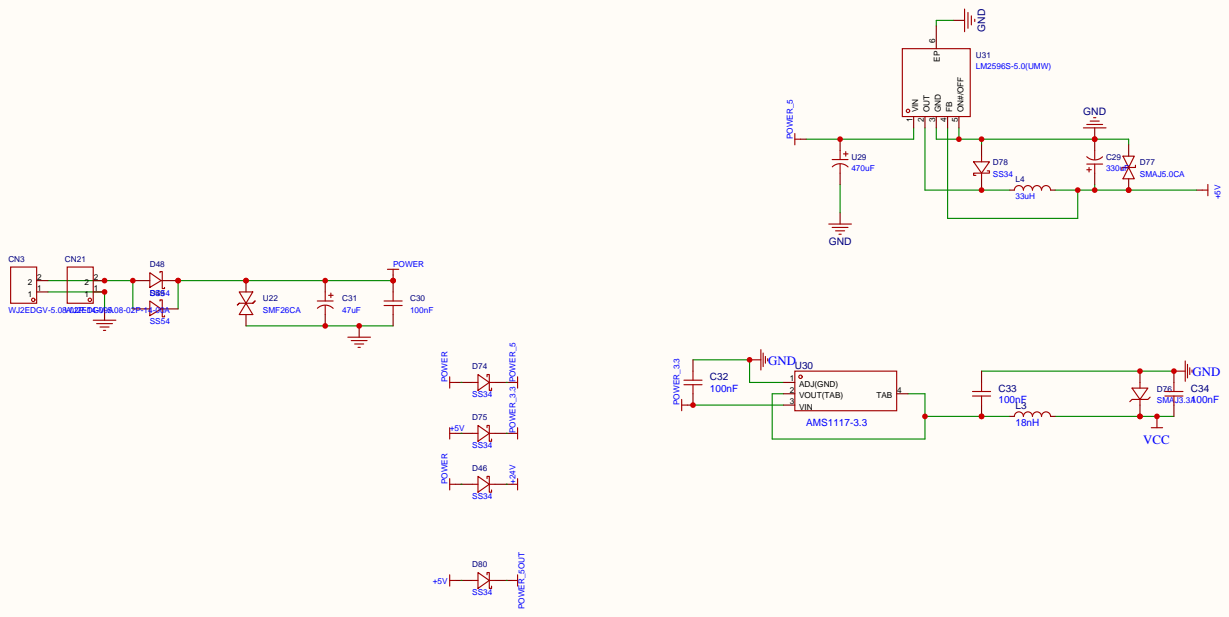
[picture p7: page 7]

原理图 | Schematic1 | 创建日期 | 2026-06-11

更新日期 | 2026-06-26

板子 | Board1 | 图页 | 电源
绘制 | | 货道板30*10
审阅

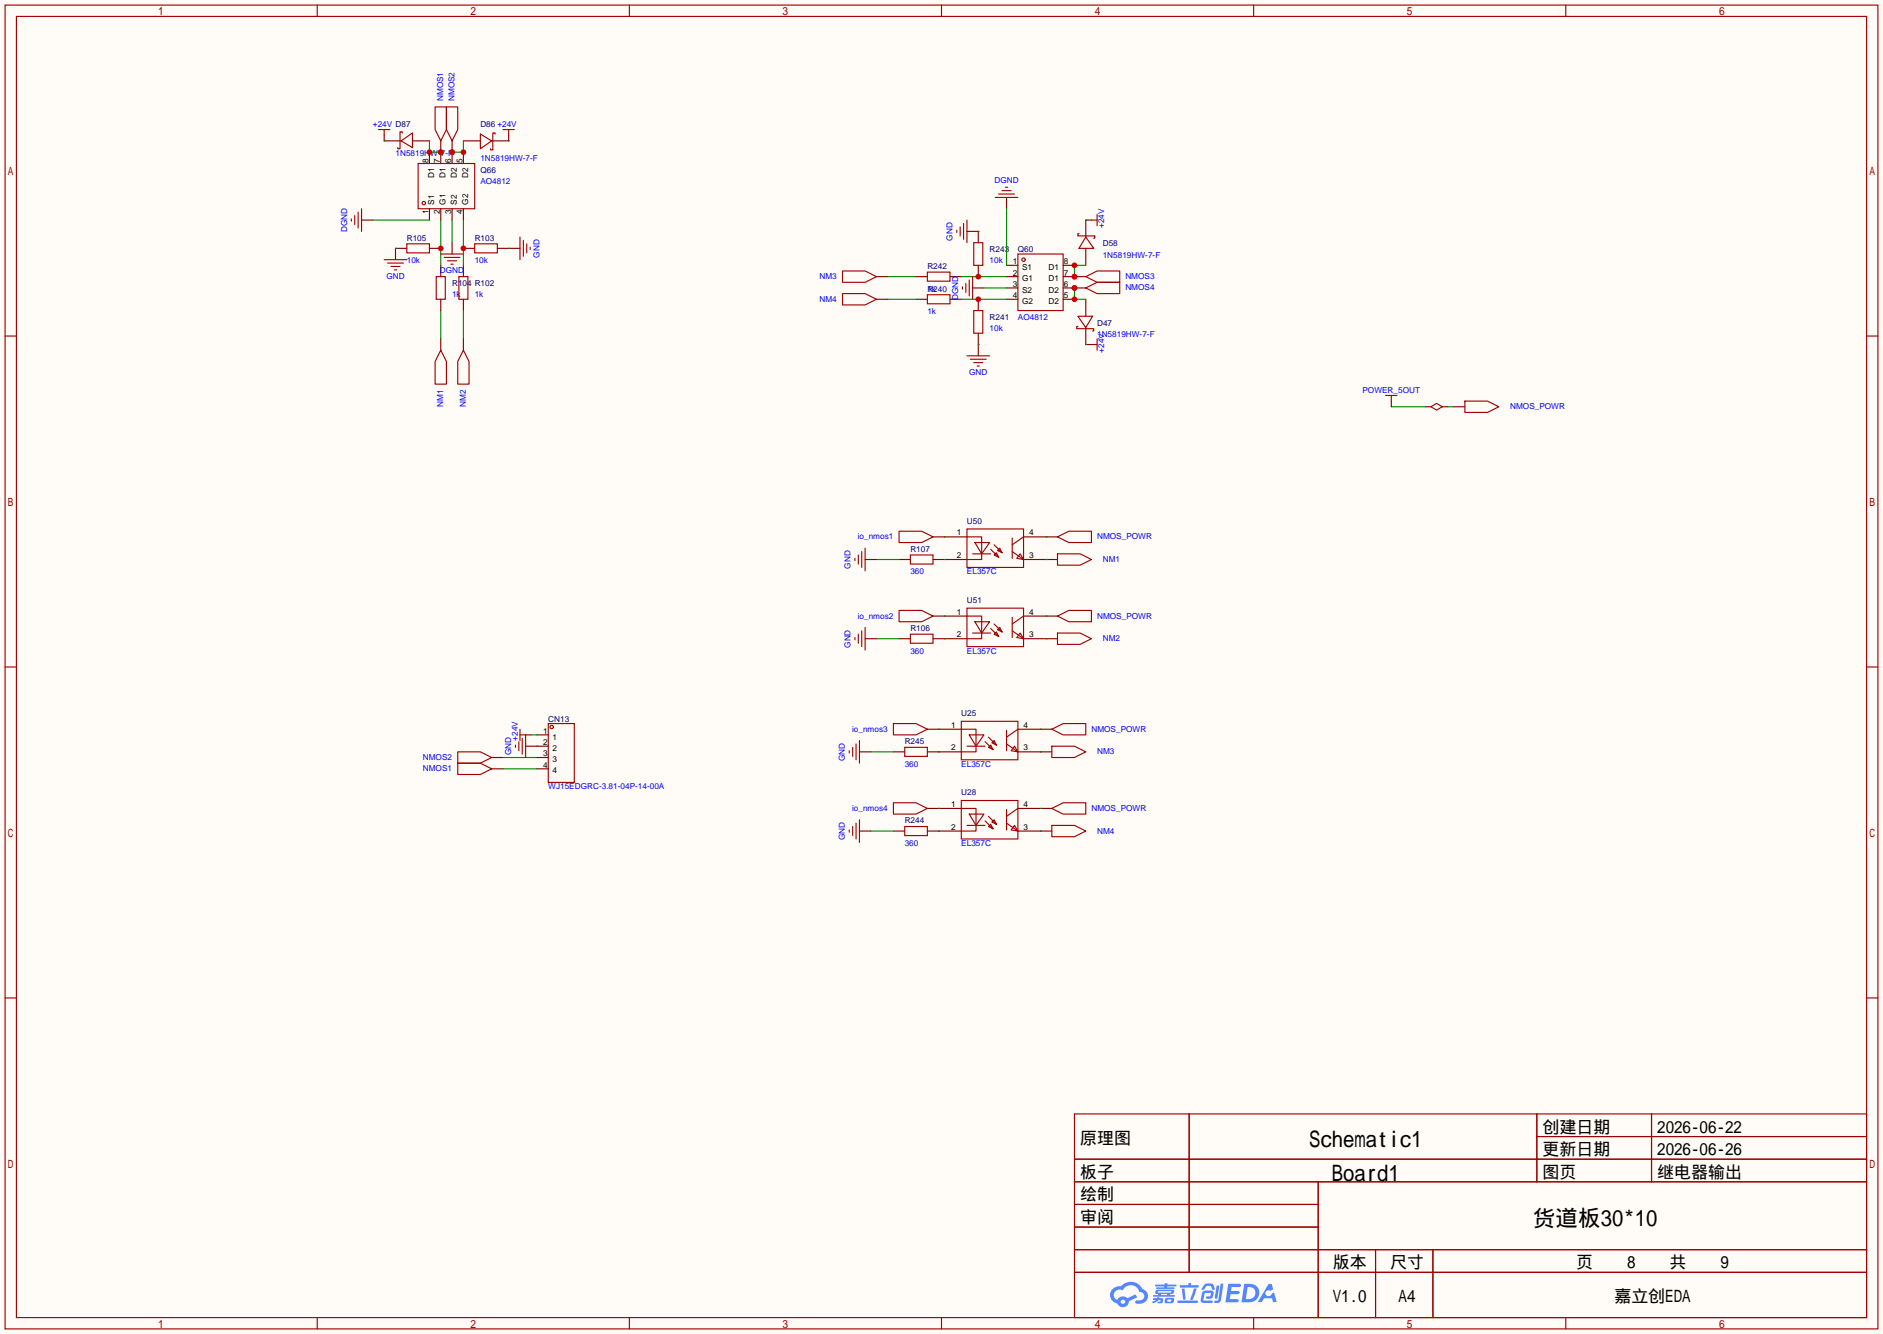
[picture p8: page 8]

GND GND

原理图 | Schematic1 | 创建日期 | 2026-06-22

更新日期 | 2026-06-26

板子 | Board1 | 图页 | 继电器输出
绘制 | | 货道板30*10
审阅

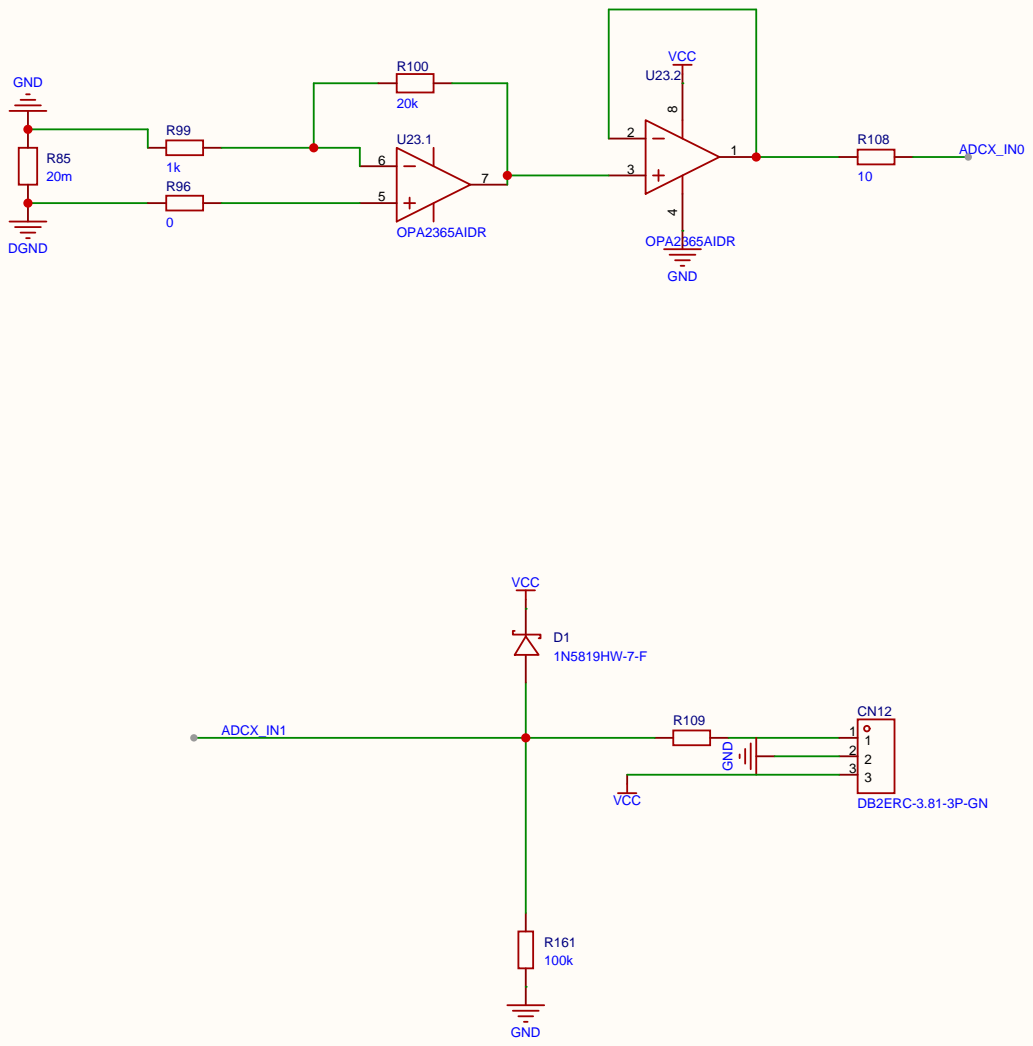
[picture p9: page 9]

原理图 | Schematic1 | 创建日期 | 2026-06-24

更新日期 | 2026-06-26

板子 | Board1 | 图页 | P1
绘制 | | 货道板30*10
审阅
