meng-jixiang/vending-lane-controller/firmware/Core/Inc/main.h

#define ION_595_DS_Pin GPIO_PIN_4
#define ION_595_DS_GPIO_Port GPIOA
#define ION_595_SHCP_Pin GPIO_PIN_5
#define ION_595_SHCP_GPIO_Port GPIOA
#define ION_595_STCP_Pin GPIO_PIN_6
#define ION_595_STCP_GPIO_Port GPIOA
#define ION_595_MR_Pin GPIO_PIN_7
#define ION_595_MR_GPIO_Port GPIOA
#define io_nmos1_Pin GPIO_PIN_0
#define io_nmos1_GPIO_Port GPIOB
#define io_nmos2_Pin GPIO_PIN_1
#define io_nmos2_GPIO_Port GPIOB
#define IOP_595_DS_Pin GPIO_PIN_12
#define IOP_595_DS_GPIO_Port GPIOB
#define IOP_595_SHCP_Pin GPIO_PIN_13
#define IOP_595_SHCP_GPIO_Port GPIOB
#define IOP_595_STCP_Pin GPIO_PIN_14
#define IOP_595_STCP_GPIO_Port GPIOB
#define IOP_595_MR_Pin GPIO_PIN_15
#define IOP_595_MR_GPIO_Port GPIOB
#define LED_Pin GPIO_PIN_8
#define LED_GPIO_Port GPIOA
