meng-jixiang/vending-lane-controller/firmware/bsp/bsp_led.c

/**
 * @file    bsp_led.c
 * @brief   BSP 层 — LED 指示灯
 */
#include "bsp_led.h"

void BSP_LED_Init(void)
{
    HAL_GPIO_WritePin(LED_GPIO_Port, LED_Pin, GPIO_PIN_RESET);
}

void BSP_LED_On(void)
{
    HAL_GPIO_WritePin(LED_GPIO_Port, LED_Pin, GPIO_PIN_SET);
}

void BSP_LED_Off(void)
{
    HAL_GPIO_WritePin(LED_GPIO_Port, LED_Pin, GPIO_PIN_RESET);
}

void BSP_LED_Toggle(void)
{
    HAL_GPIO_TogglePin(LED_GPIO_Port, LED_Pin);
}

void BSP_LED_Blink(uint8_t times, uint16_t interval_ms)
{
    for (uint8_t i = 0; i < times; i++) {
        BSP_LED_On();
        HAL_Delay(interval_ms);
        BSP_LED_Off();
        if (i < times - 1) {
            HAL_Delay(interval_ms);
        }
    }
}
