meng-jixiang/vending-lane-controller/(commit log)

2026-07-02 feat: 项目初始化 — 文档、硬件文件、工具脚本
    - docs/: 固件规格书、通讯协议规格书、硬件原理图分析
    - hardware/: 原理图PDF、Gerber文件、器件规格书
    - firmware/Config/: board_config.h 板级引脚和参数定义
    - tools/serial_test.py: M109E兼容串口测试工具
    - .gitignore, CHANGELOG.md
2026-07-02 feat: 合并 CubeMX 工程 (lane_board.ioc) — 实际PCB引脚方案
    - CubeMX 生成: CMake + GCC ARM + HAL Driver
    - IWDG 看门狗已启用
    - USART1=调试日志(115200), USART3=RS-485通讯(9600,DMA)
    - P端595: PB12-15, N端595: PA4-7
    - 到位检测: PC13/14/15 + PB3-9 (10路)
    - 光幕: PA12 + PA15 (2路)
    - NMOS: PB0/1 + PA2/3 (4路)
    - ADC: PA0电流 + PA1温度
    - board_config.h V2.0 更新为实际引脚
    - .vscode 配置: DAP-Link调试 + CMake构建 + clangd
    - App/Drivers_custom 模块占位文件
2026-07-02 feat: 实现地址设置功能 (0xFF指令) + 参数掉电存储
    - param_store: Flash 双页轮转 EEPROM 模拟
    - Param_SaveAddr/GetAddr/Init/ResetDefaults
    - 掉电保存，自动加载，地址范围校验 1-8
    - protocol: M109E 协议框架 + 0xFF 指令处理
    - CRC16-MODBUS 校验
    - USART3 中断接收 20 字节定长帧
    - 0xFF 广播设置地址，LED 闪烁确认
    - 0x01/0x03/0x07 指令占位响应
    - main.c: 启动时 Param_Init + Proto_Init
    - LED 闪烁从机地址次数确认启动
    - 主循环 Proto_Process + IWDG 喂狗
    - HAL_UART_RxCpltCallback 回调
    [main.c, param_store.c, param_store.h, protocol.c, protocol.h]
2026-07-02 refactor: 分层架构重构 — bsp/device/service/app 四层解耦
    bsp/ 板级硬件封装 (唯一操作 HAL 的层)
    ├── bsp_led.c/h LED 指示灯
    ├── bsp_uart.c/h USART1调试 + USART3 RS-485
    ├── bsp_595.c/h 74HC595 矩阵驱动 (P端+N端)
    ├── bsp_gpio.c/h 到位检测 + 光幕 + NMOS
    └── bsp_adc.c/h 电流/温度 ADC
    service/ 通用服务 (不碰硬件)
    ├── protocol.c M109E 协议 (通过 bsp_uart/bsp_led)
    └── param_store.c Flash 参数存储
    device/ 设备驱动 (预留)
    app/ 业务逻辑 (预留)
    依赖链: main.c → service → bsp → HAL
    protocol.c 不再直接调用 HAL_GPIO, 全部通过 bsp 接口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
2026-07-02 docs: 添加 SYSTEM.md 系统说明文档
    覆盖: 架构分层、目录结构、引脚分配、模块API、数据流、编译烧录
2026-07-02 feat: 实现全部业务模块 — motor/laser/fault_log/vending
    device/motor.c/h 电机控制状态机
    - 14种电机类型兼容M109E
    - IDLE→PRECHECK→RUNNING→STOPPING→DONE
    - 过流/欠流/超时/光幕自检
    - 到位检测 (row0-9)
    device/laser.c/h 光幕控制
    - 自检 + 掉货检测 + 遮挡计时
    service/fault_log.c/h 故障日志
    - 环形缓冲 10 条，自动记录故障
    app/vending.c/h 出货主流程
    - 串联 motor+laser+fault_log
    - main.c 接入 Vending_Init/Process
